Taranis-Project/Taranis_minifusee/README.md

# Taranis_minifusee
Files used for our first minifusee
