Taranis-Project/Taranis_minifusee/Electronique/Composants mini-fusée.docx

Carte arduino grande :

Référence : arduino

Epaisseur max : 15 mm masse : 23,0 g

53,5 mm

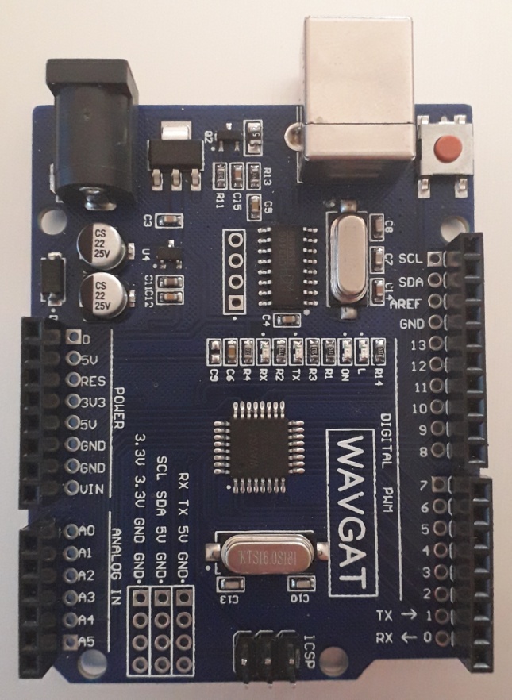
[picture p1: figure]

= 74,5 mm

6 mm

68,5 mm

Carte arduino petite :

Référence : pro mini

Epaisseur max : 13,5 mm masse : 2,6 g

18 mm

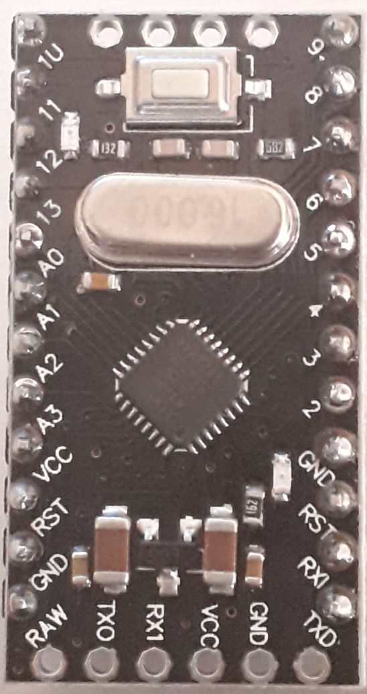
[picture p2: figure]

33,5 mm

Accéléromètre-Gyroscope :

Référence : MPU 6050

Epaisseur max : 11,5 mm masse : 1,6 g

16,5 mm

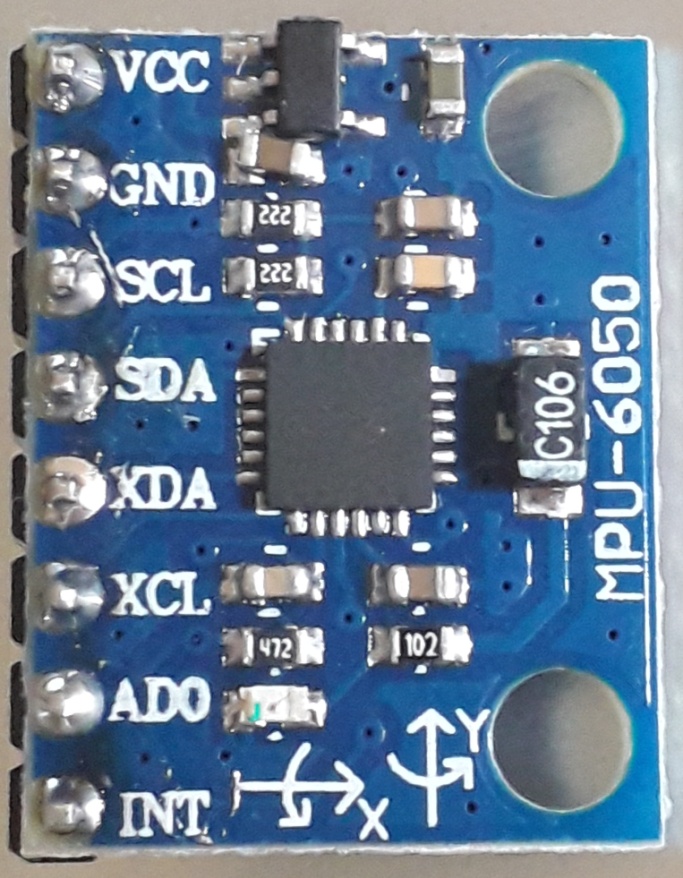
[picture p3: figure]

20,5 mm

Altimètre :

Référence : CJMCU-280E BME 280

Epaisseur max : 11,5 mm

12,0 mm

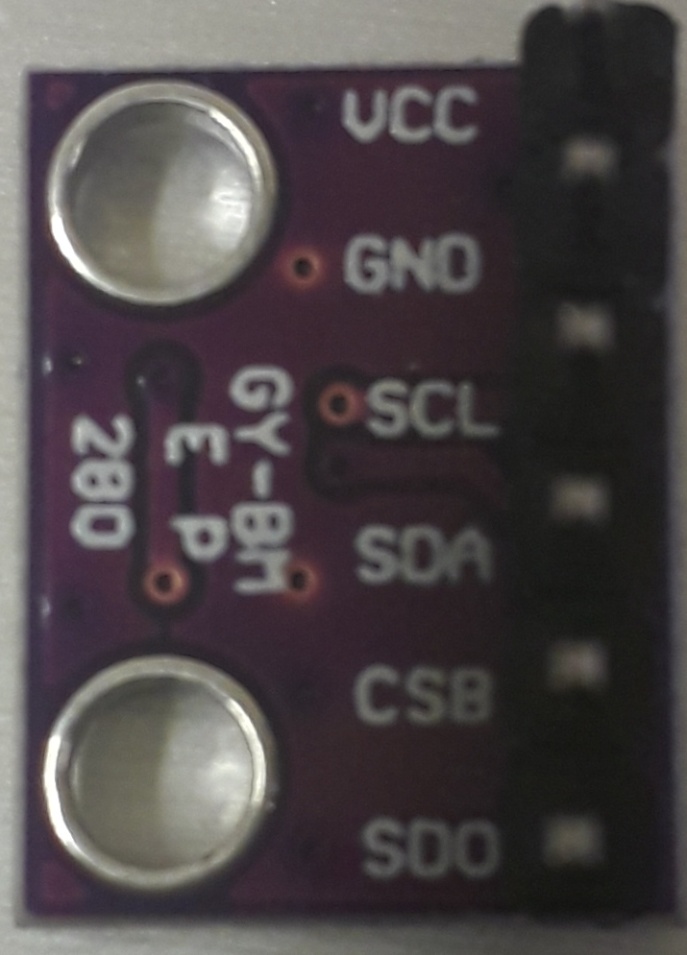
[picture p4: figure]

15,5 mm

Module SD

Référence : micro SD card module

Epaisseur max : 11,5 mm masse : 1,9 g

21,0 mm

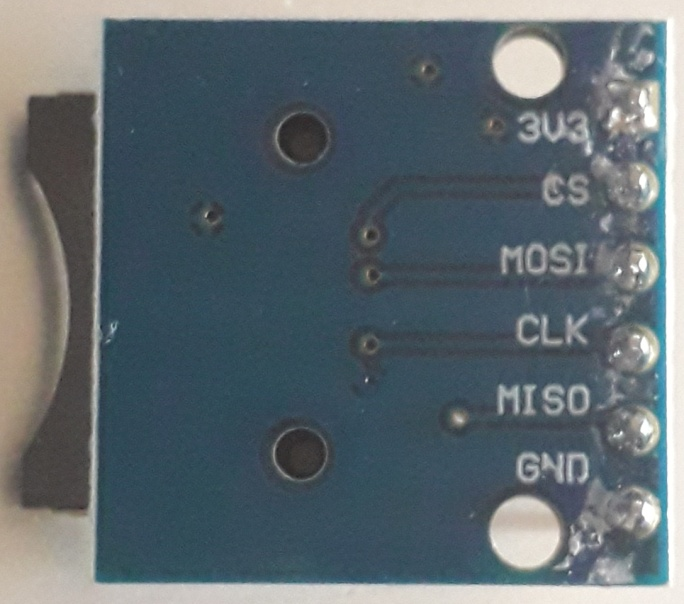
[picture p5: figure]

18,5 mm
