Taranis-Project/Taranis_minifusee/Intégration/Contrainte intégration.docx

- Partie électronique imperméable
- Interrupteurs et LED à l’extérieur
- Communiquer avec les cartes sur la rampe
- Possibilité de démontage et remplacement des piles
- Centre de masse au milieu
- Connexion et déconnexion servomoteur ???
