Taranis-Project/Taranis_minifusee/Rédaction/Suivi des séances.docx

Séance du 05/02/2020

Objectif : répartir les tâches de travail au sein du groupe

Chef de projet : Alexandre Leleux

Responsable électronique : Léo-Paul Laurent

Responsable CAO : Florian Levray

Responsable Intégration : Marie Brun

Suivi des projets : Corentin Copet

Numéro de tel Planète Science pour nous aider tous les mercredis de 19H à 00H : 01 69 02 76 10

Travail effectué :

Rouge : Vcc Noir : Ground Blanc : Rx Vert : Tx

Processeur 3.3V USB ASP

Alexandre a noté les dimensions de tous les composants électroniques utilisés.

Florian a réparé le câble de connexion mini et a réussi à communiquer une mini avec C++.

Corentin a réalisé le schéma électronique sur Fritzing.

Melvin a programmé le déclenchement du parachute, est parti plus tôt pour programmé à 17H04.

Léo-Paul a regardé les programmes pour voir comment modifier les PIN de connexion.

Marie a vérifié les cartes, a soudé, a lu le dossier d’intégration.

A reprendre :

Problème de connexion entre l’altimètre et le gyroscope car connecté sur un même pin SDA et SCL.

Voir connexion I2C
