Taranis-Project/Taranis_minifusee/Chronologie.ods

Sheet: Chronologie
Décompte | Durée | Lieu | Opération | Séquence | Validée | Responsable |  |  |  | Version simplifié
 |  |  |  |  |  | Florian | Marie | Léo-Paul
 |  |  | Veille
-14h20 ou plus | 2h00 | Ville | Rechargement piles 9V | I |  | X |  |  | Piles | Caméra 1 | Lancer | Mettre coiffe avant/aprés?
-12h20 | 5h00 | Chambre | Rechargement ordinateurs | I |  | X | X |  | Ordinateur + cable de rechargement | Caméra 2 | Lancer
-12h15 | 5h00 | Chambre | Rechargement des caméras | I |  | X | X |  | cable de rechargement caméra | Branche jack
-12h10 | 10 min | Chambre | Test logiciel d'enregistrement/connexion internet | I |  | X |  | X |  | Test anti ouverture
-12h05 | 5 min | Chambre | Test logiciel d'enregistrement Sérial | I |  | X |  | X |  | Télém | Bas
 |  |  | Pres déplacement |  |  |  |  |  |  | Exp | Bas
-01:52 | 5 min | Ordinateur | Vérification du matériel | II |  | X | X |  | Ordinateurs/piles/télémesure/pinces/trounevis/ 3 cartes SD/Jack/Fusée/go pro + mini cam + scotch | Séq | Bas
-01:47 | 5 min | Ordinateur | Lancement du stream et de l'enregistrement | II |  | X | X |  |  | Servo oreille
-01:42 | 0 min | Caméra ordi | Jean michel cadrage | II |  |  |  | X |  | Vérif télém
-01:42 | 3 min | Fusée | Mise en place des piles | II |  | X |  |  | Piles | Vérif données corectes
-01:39 | 1 min | Fusée | Mise en place des cartes SD vierges données/ vierge caméra 1 & 2 | II |  | X |  |  | cartes SD
 |  |  | Test prés montage |  |  |  |  |  | pince
-01:38 | 3 min | Fusée | Test allumage séquenceur/données/caméra1 & 2 | III |  | X
-01:35 | 1 min | Ordinateur | Vérification télémétrie | III |  |  |  | X
-01:34 | 5 min | Ordinateur | Vérification des cartes SD | III |  | X
-01:29 | 3 min | Ordinateur | Effacer cartes SD | III |  | X
-01:26 | 2 min | Fusée | Mise en place carte SD | III |  | X
-01:24 | 3 min | Fusée | Mise en place éléctronique et vissage. | III |  | X | X
-01:21 | 1 min | Fusée | Test allumage séquenceur/exp | III |  | X |  | X
-01:20 | 1 min | Fusée | Vérification télémétrie | III |  | X |  | X
-01:19 | 3 min | Fusée | Vérfication ouverture parachute | III |  | X | X
-01:16 | 3min | Fusée | Mise en place finale de la trappe | III |  | X |  | X
-01:13 | 6 min | Fusée | Test caméra 1 & 2 | III |  | X
-01:07 | 3 min | Fusée | Mise en place caméra 1 & 2 (serrage fort) | III |  | X | X
-01:04 | 5 min | Fusée | Serrage de toutes les vis | III |  | X | X
-00:59 | 5 min | Fusée | Préparation déplacement fusée | III |  | X | X
-00:54 | 5 min | Matériel | Chargement de la fusée + cable jack + pince + télém + ordinateur+tournevis+clé | III |  | X | X |  | Ordinateurs/piles/télémesure/pinces/trounevis/ 3 cartes SD/Jack/Fusée
 |  |  | Déplacement vers la rampe
-00:49 | 15 min | Camion | Protection de la fusée |  |  | X | X |  | Sangle/plaque de transport
 |  |  | Test en tente club
-00:34 | 1 min |  | Branchement prise Jack | IV | X |  | X
-00:33 | 1 min |  | Allumage séquenceur et expérience | IV |  | X
-00:32 | 1 min |  | Vérfication télémétrie | IV | X | x
-00:31 | 1 min |  | Arrêt séquencer et expérience + rangement jack | IV |  | X | X
-00:30 | 1 min | Fusée | Lancement caméra 1 HD (bouton Haut/Bas/Haut) + prendre heure | IV
-00:29 | 1 min | Fusée | Lancement caméra 2 HD (bouton Haut/Bas/Haut) + prendre heure | IV |  | X | X
 |  |  | En rampe | IV |  | X
-00:28 | 1 min | Caméra ext | Mise en place caméra sur rampe | IV |  | X | RESP CHRONO
-00:27 | 1 min | Caméra ext | Mise en place caméra trépied | IV |  | X | RESP CHRONO
-00:26 | 1 min | Fusée | Vérif trappe | IV |  | X | RESP CHRONO
-00:25 | 1 min | Fusée | Mise en rampe de la fusée | IV |  | X | RESP CHRONO
-00:24 | 1 min | Fusée | Allumage expérience 3 | IV |  | X | RESP CHRONO
-00:23 | 1 min | Fusée | demander allumage télém | IV |  | X | RESP CHRONO
-00:22 | 1 min | Fusée | allumage télém 2 | IV |  | X | RESP CHRONO
-00:21 | 1 min | Ordinateur | Vérification réception donnée | IV |  | X | RESP CHRONO
-00:20 | 1 min | Ordinateur | Vérification qualité donnée | IV |  |  | RESP CHRONO | X
-00:19 | 1 min | Ordinateur | lancement de la réception de la télémétrie | IV |  | X | RESP CHRONO
-00:18 | 2 min | Ordinateur | lancement de l'enregistrement de la télémétrie | IV |  | X | RESP CHRONO
-00:16 | 3 min | Pyrotechnicien | Orientation de la rampe | V |  | PS | RESP CHRONO
-00:13 | 3 min | Fusée | Branchement et maintient de la prise Jack | IV |  | X | RESP CHRONO
-00:10 | 1 min | Fusée | Acroche de la prise jack sur le pas de tir | IV |  | X | RESP CHRONO
-00:09 | 1 min | Fusée | Allumage séquenceur 1 | IV |  | X | RESP CHRONO
-00:08 | 30 sec | Fusée | Bruit servomoteur ? | IV |  | X | RESP CHRONO
-00:06 | 1 min | Ordinateur | Vérification donnée Sérial | IV |  | X | RESP CHRONO
-00:05 | 1 min | Fusée | Vérification visuelle LED/Cable Jack | IV |  | X | RESP CHRONO
-00:04 | 2 min | Ordinateur | Evacuation des lieux
 |  |  | Tente pupitre
-00:02 | 1 min | Télémétrie | Antenne perpendiculaire à la fusée | V |  |  | X |  |  |  |  |  | X
-00:01 | 1 min | Vidéos | Caméra / téléphones / ralentis / suivit fusée | V |  | X | X
00:00 | 0 min | Télémétrie | Ultime vérification télémétrie/stream/enregistrement | V |  | X | X | X
 |  | Gros bouton rouge | Lancement de la fusée | V |  | X
 |  |  | ENJOY(Florian Crie probablement)
 |  |  | Post lancement
Inconnue |  |  | Impression | VI |  | X | X
Inconnue |  |  | Sauvegarde des données Télémétrie | VI |  | X |  | X
Inconnue |  |  | Analyse des données | VI |  | X | X
 |  |  | Récupération |  |  |  |  | X
Inconnue |  |  | Prendre des photos avant de déplacer la fusée | VII |  | X | X
Inconnue |  |  | Sauvegarde des données | VII |  | X | X | X
Inconnue |  |  | Sauvegarde des vidéos | VII |  | X | X | X
Inconnue |  |  | Analyse des données | VII |  | X | X | X
Inconnue |  |  | Analyse des vidéos | VII |  | X | X | X

Sheet: Liste_matériel
Pour le lancement | Réparation |  | Vidéo
Fusée | Imprimante 3D |  | Trépied
Support | fil imprimante |  | Pied pour téléphone x2
sangle | glue |  | support téléphones x2
Pince pour caméra | vis rechange |  | OBS
caméra mini | étain
scotch | station soudure
trépied
Go pro | gaine
Ordi 1 | crayon flux
Ordi 2 | tresse à dessouder
cable arduino 1 | Couture
cable arduino 2 | Toile parachute
Télém 1 | bord de couture | Tant pis
Télém 2 | fil de para
Téléphone streaming | papier à poncer
Clé allen | faux moteur
Cable recharge ordi | Servomoteur
Tournevis fusée | scotch
sac/boite pour vis | pistocole
Jack fusée | recharge pistocole
ficelle de secour | élastiques
Caméra melvin live
cable rechargement caméra
Piles 9V neuve x2
recharge pile 9V
Cable téléversement
Composant en double
Arduino mini
MPU
BME
Régulteur
Condo 1
Condo 2
Fils
Connecteur Pile
club golf
