Taranis-Project/Taranis_minifusee/CAO/Taranis Case equipement.stl

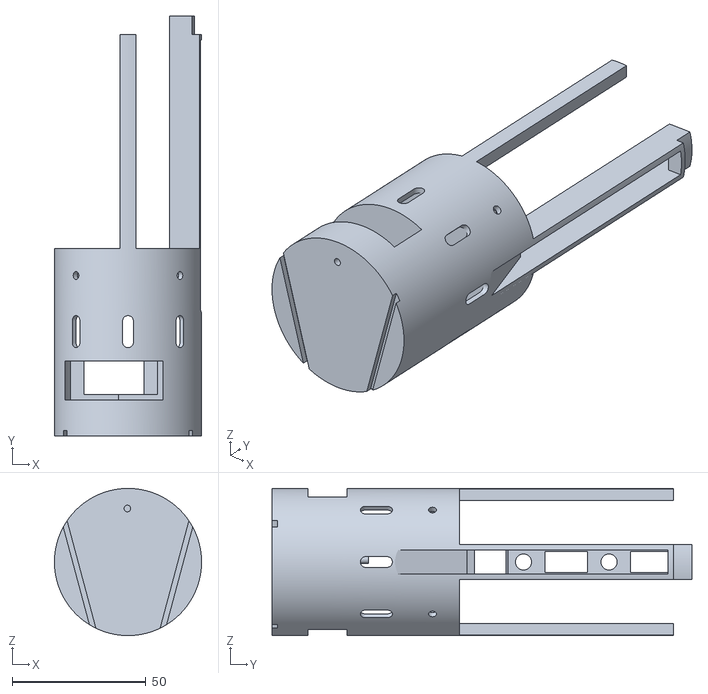
[picture p23: CAD file, 2023-11-09]
CAO/Taranis Case equipement.stl
55.0 x 157.0 x 55.0
