Taranis-Project/Taranis_minifusee/Case a equipement STL.obj

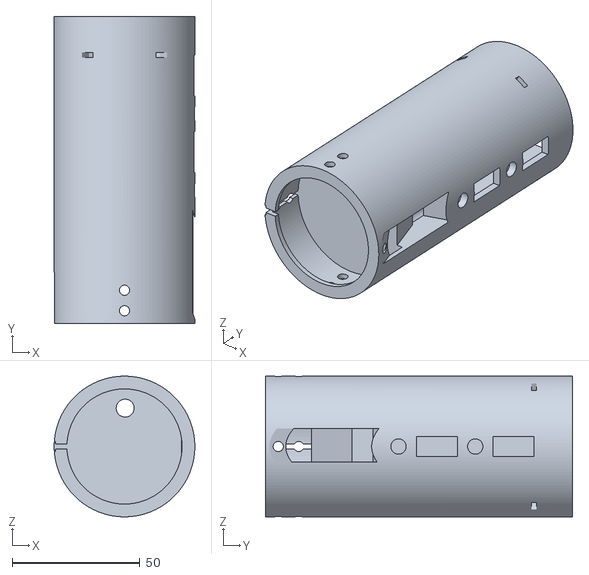
[picture p24: CAD file, 2023-11-09]
Case a equipement STL.obj
55.0 x 120.0 x 55.0
