Taranis-Project/Taranis_minifusee/CAO/Taranis Pochoir bac.stl

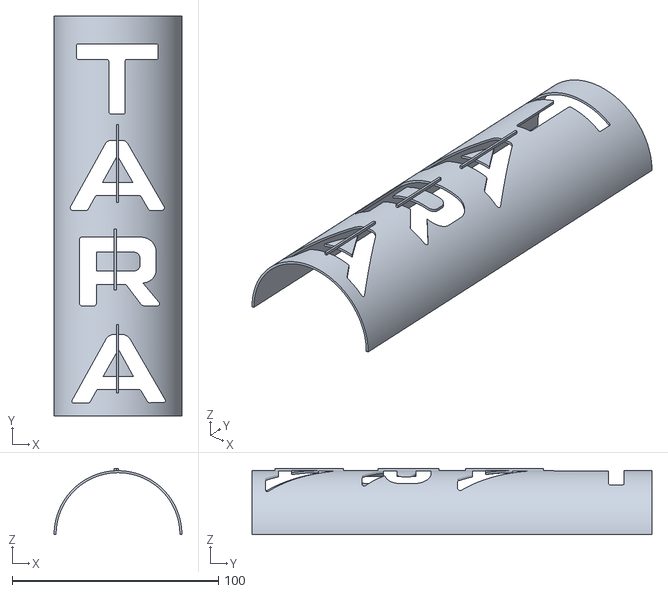
[picture p25: CAD file, 2023-11-09]
CAO/Taranis Pochoir bac.stl
62.0 x 194.0 x 32.1
