Taranis-Project/Taranis_minifusee/CAO/Taranis Base aileron et moteur.stl

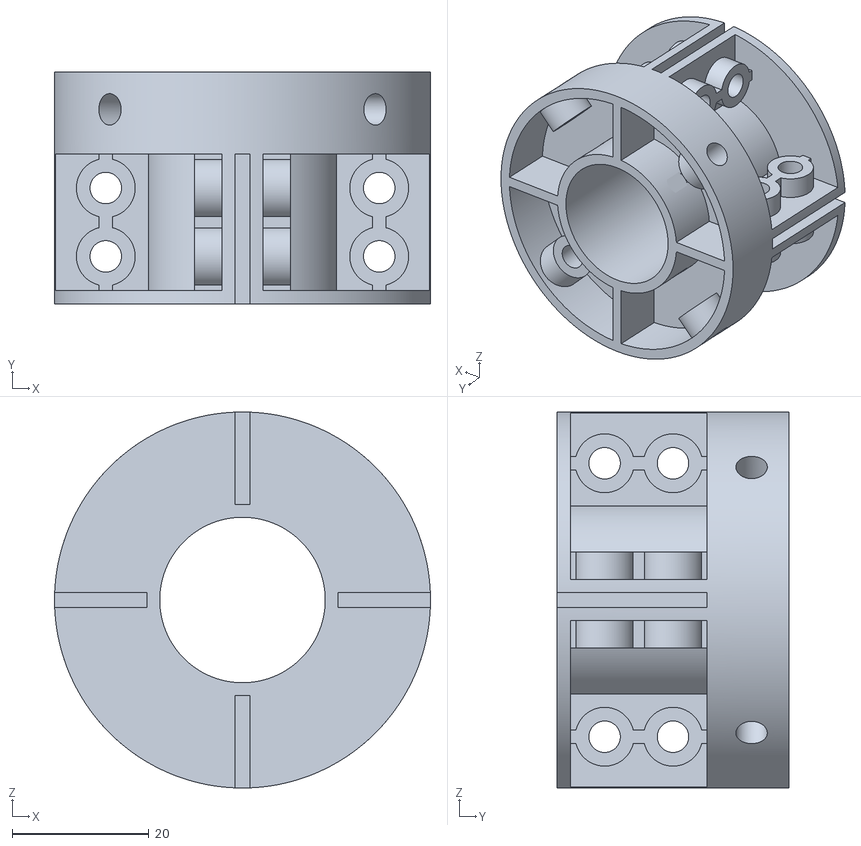
[picture p26: CAD file, 2023-11-09]
CAO/Taranis Base aileron et moteur.stl
55.0 x 34.0 x 55.0
