Taranis-Project/Taranis_minifusee/CAO/TelemHaut.stl

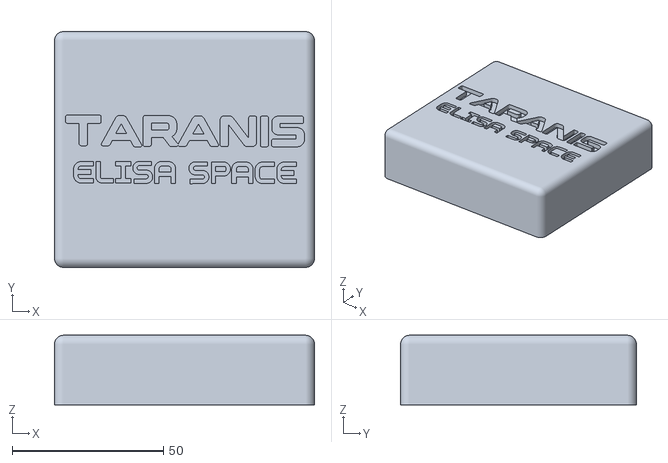
[picture p27: CAD file, 2023-11-09]
CAO/TelemHaut.stl
86.0 x 78.0 x 23.0
