Taranis-Project/Taranis_minifusee/CAO/Moteur Pandora.stl

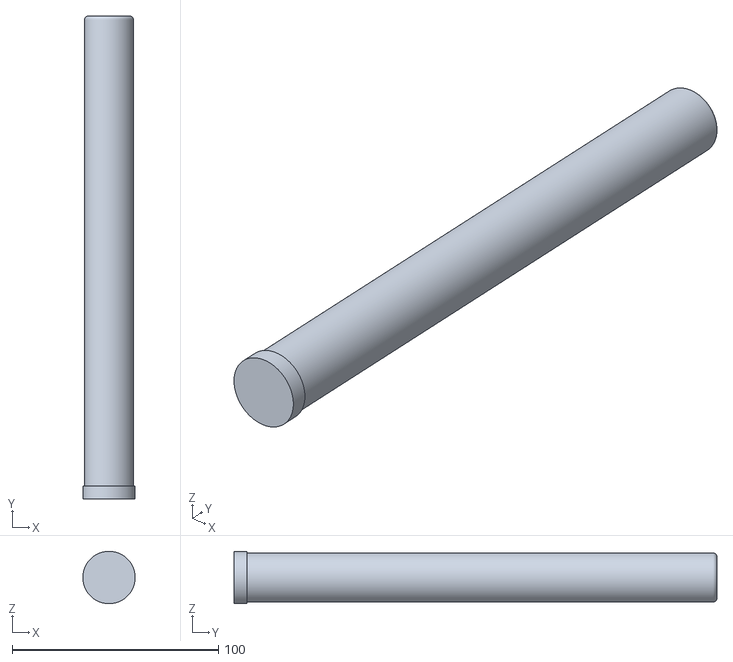
[picture p28: CAD file, 2023-11-09]
CAO/Moteur Pandora.stl
25.4 x 234.4 x 25.4
