Taranis-Project/Taranis_minifusee/CAO/Taranis Camera2.stl

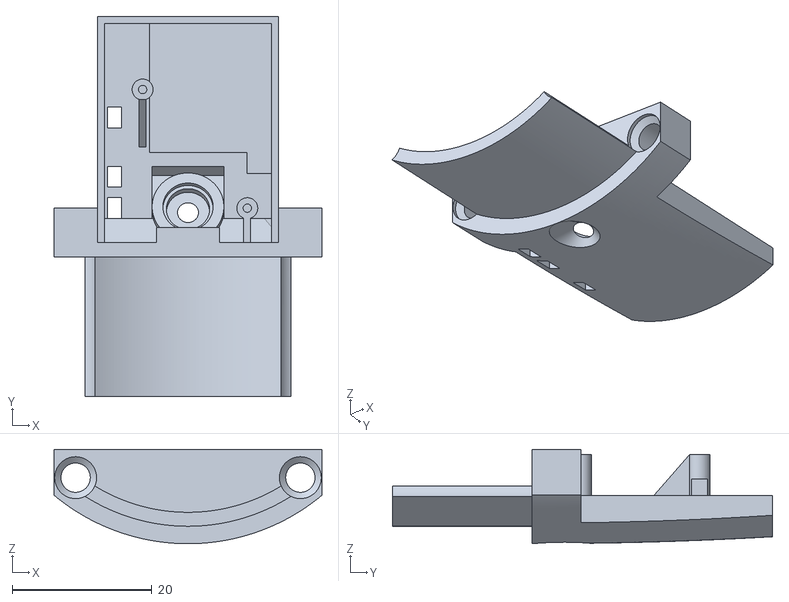
[picture p29: CAD file, 2023-11-09]
CAO/Taranis Camera2.stl
38.4 x 54.5 x 13.5
