Taranis-Project/Taranis_minifusee/CAO/Taranis Pochoir.stl

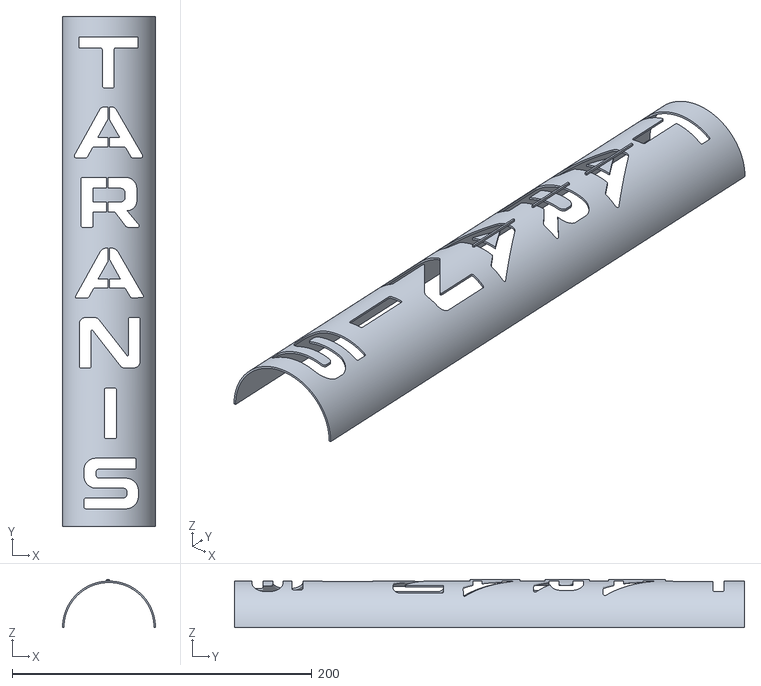
[picture p30: CAD file, 2023-11-09]
CAO/Taranis Pochoir.stl
62.0 x 340.0 x 32.1
