Taranis-Project/Taranis_minifusee/CAO/Taranis Pignon.stl

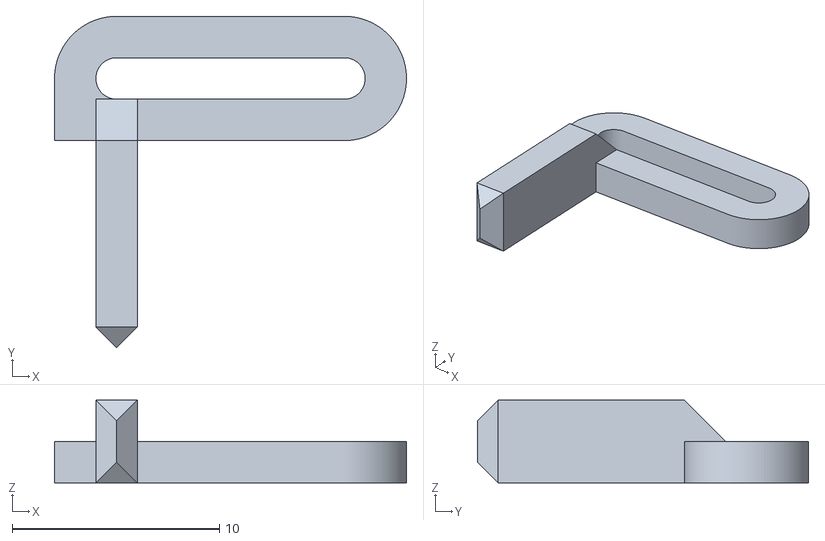
[picture p31: CAD file, 2023-11-09]
CAO/Taranis Pignon.stl
17.0 x 16.0 x 4.00
