Taranis-Project/Taranis_minifusee/CAO/Taranis Support moteur.stl

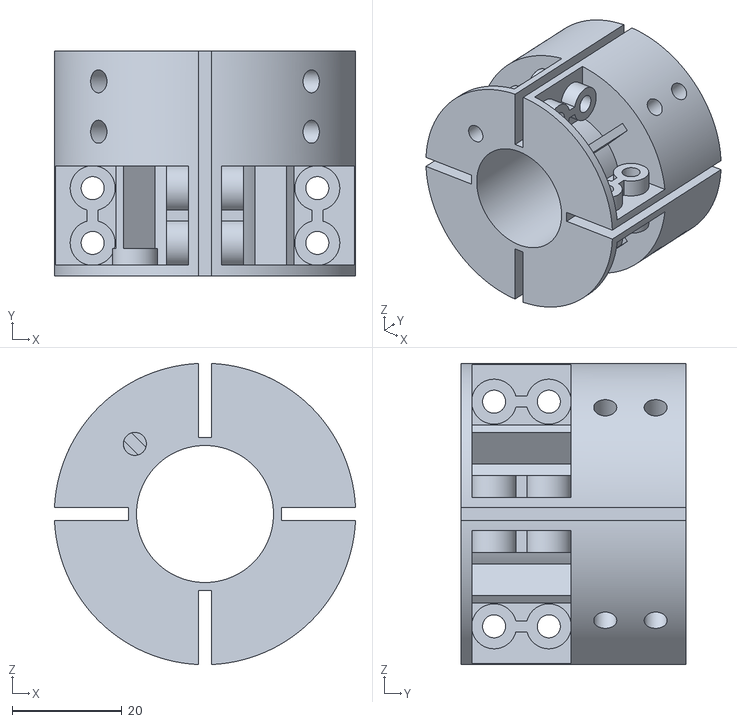
[picture p32: CAD file, 2023-11-09]
CAO/Taranis Support moteur.stl
54.9 x 41.0 x 54.9
