Taranis-Project/Taranis_minifusee/CAO/Taranis Pochoir Elisa Bas.stl

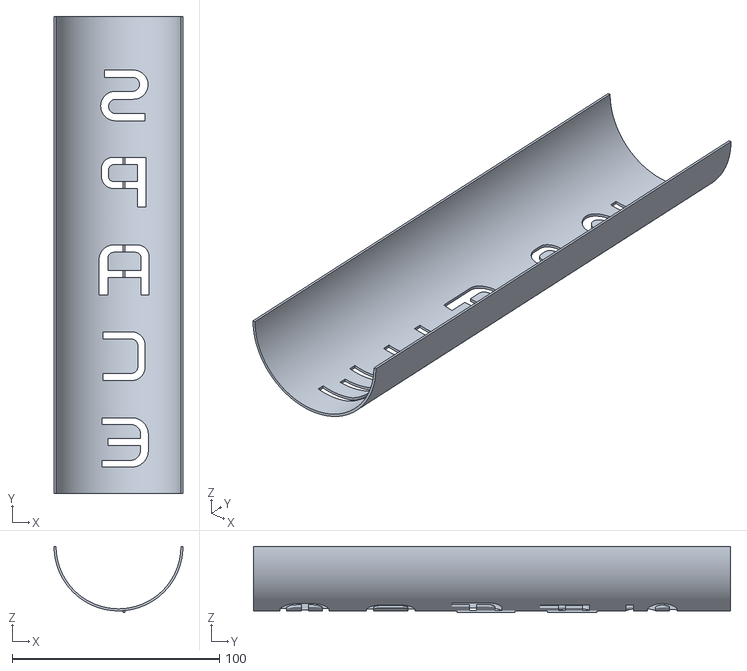
[picture p33: CAD file, 2023-11-09]
CAO/Taranis Pochoir Elisa Bas.stl
62.2 x 230.0 x 31.9
