Taranis-Project/Taranis_minifusee/CAO/TelemText.stl

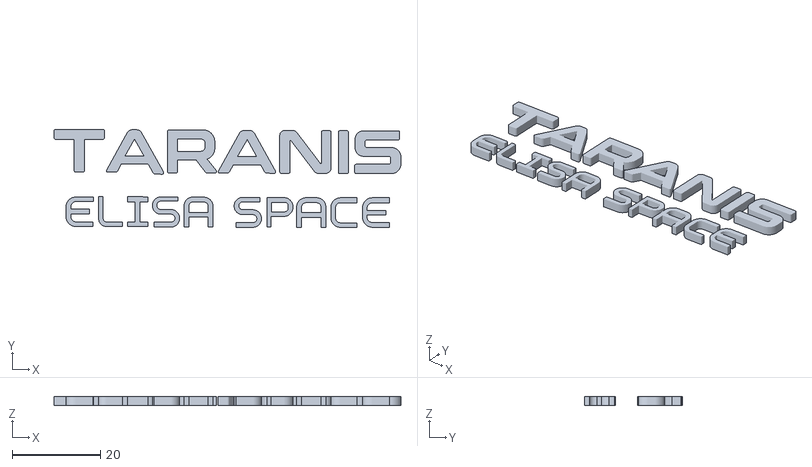
[picture p34: CAD file, 2023-11-09]
CAO/TelemText.stl
78.7 x 22.3 x 2.00
