Taranis-Project/Taranis_minifusee/CAO/Taranis Paroie retention moteur.stl

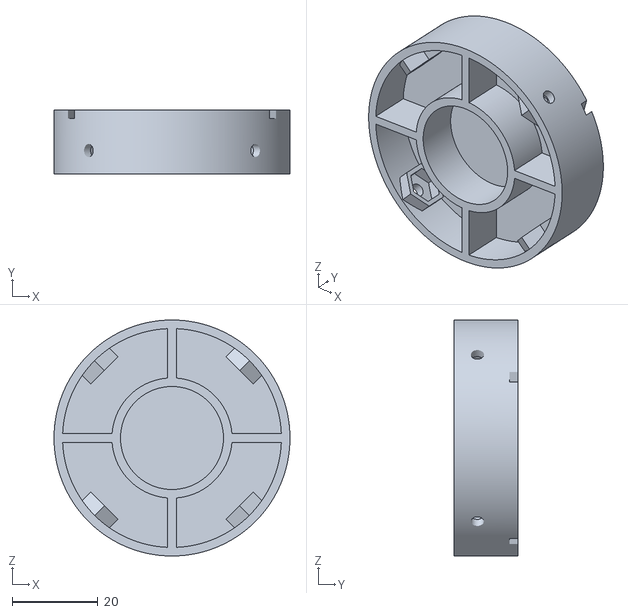
[picture p35: CAD file, 2023-11-09]
CAO/Taranis Paroie retention moteur.stl
55.0 x 15.0 x 55.0
