Taranis-Project/Taranis_minifusee/CAO/Taranis Pied.stl

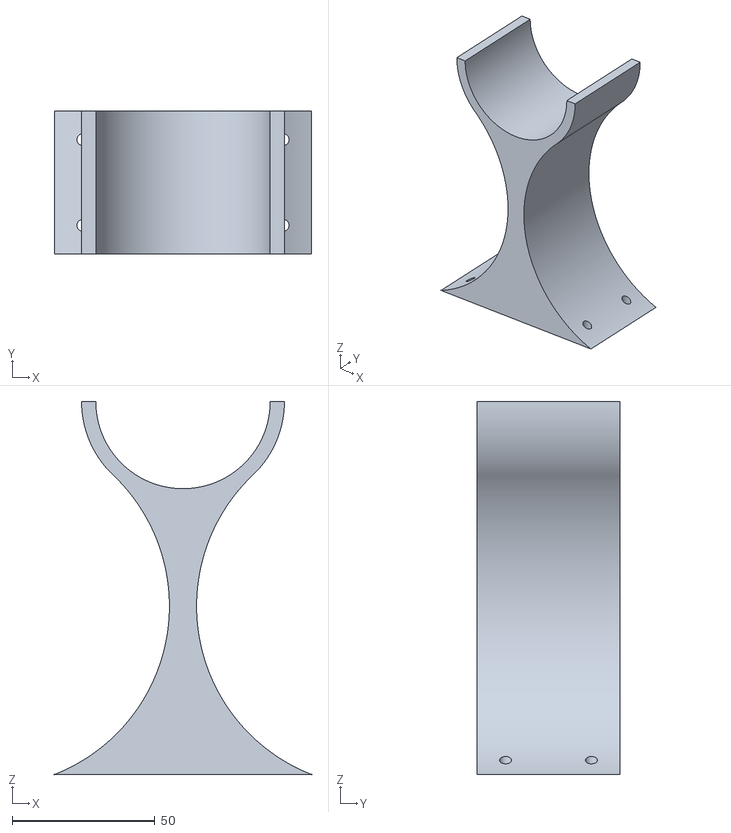
[picture p36: CAD file, 2023-11-09]
CAO/Taranis Pied.stl
90.0 x 50.0 x 130.5
