Taranis-Project/Taranis_minifusee/CAO/BQW2_Taranis Support aileron et moteur.3mf

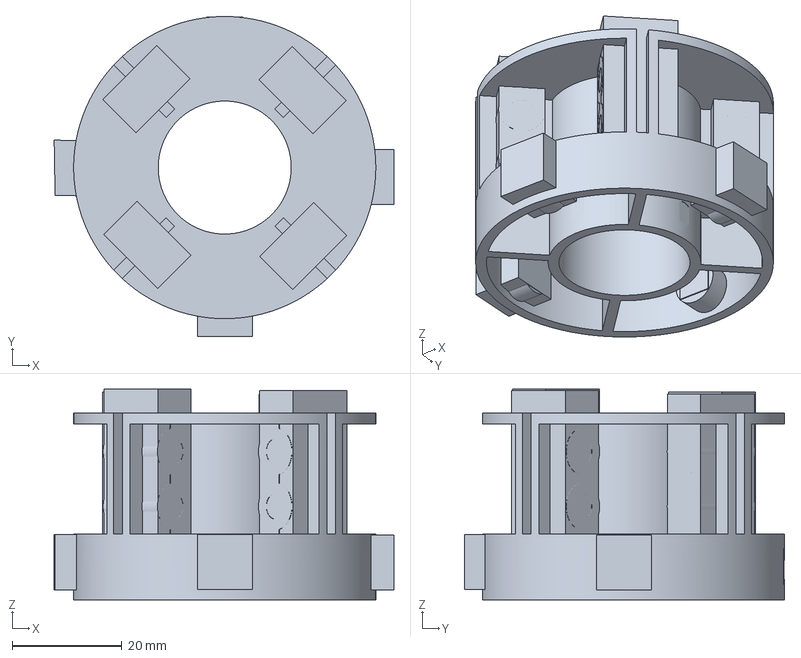
[picture p37: CAD file, 2023-11-09]
CAO/BQW2_Taranis Support aileron et moteur.3mf
61.8 x 58.3 x 38.4 mm
