Taranis-Project/Taranis_minifusee/CAO/Taranis Pochoir Elisa Haut.stl

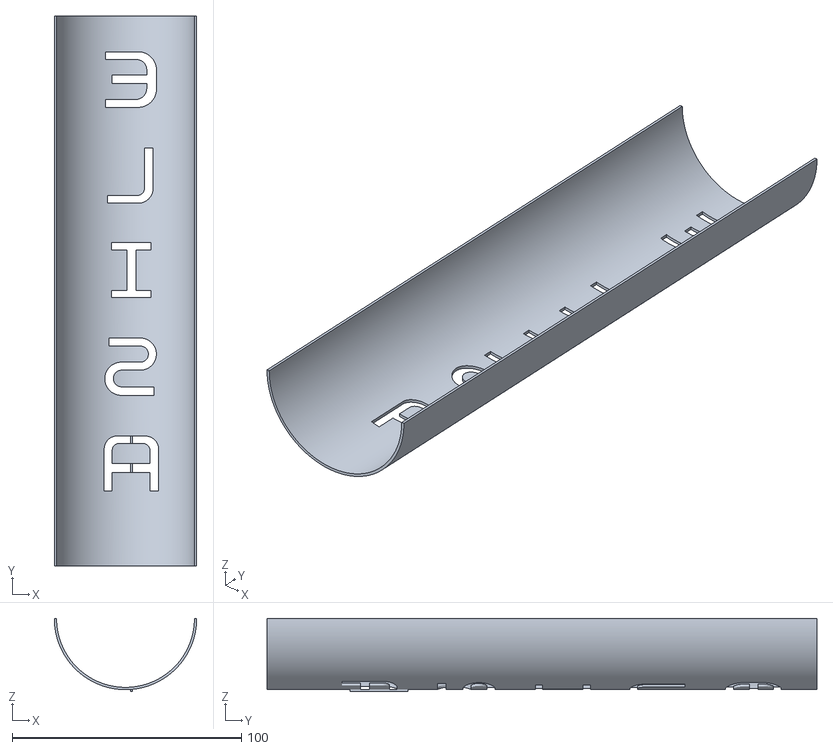
[picture p38: CAD file, 2023-11-09]
CAO/Taranis Pochoir Elisa Haut.stl
62.2 x 240.0 x 31.9
