Taranis-Project/Taranis_minifusee/CAO/Taranis Case parachute et electronique.stl

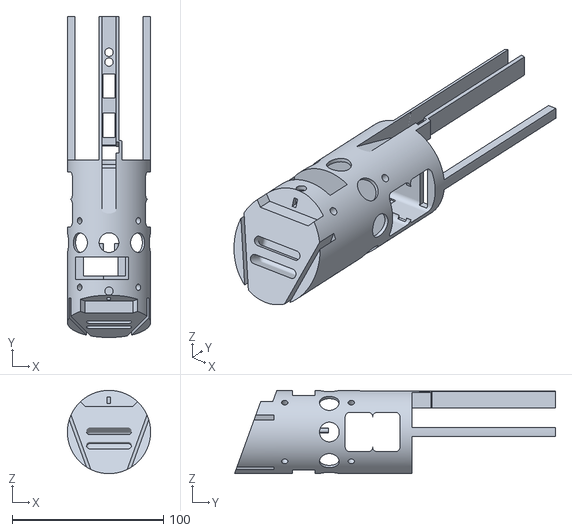
[picture p39: CAD file, 2023-11-09]
CAO/Taranis Case parachute et electronique.stl
55.0 x 212.2 x 55.0
