Taranis-Project/Taranis_minifusee/CAO/BQW2_Taranis Case parachute et electronique.3mf

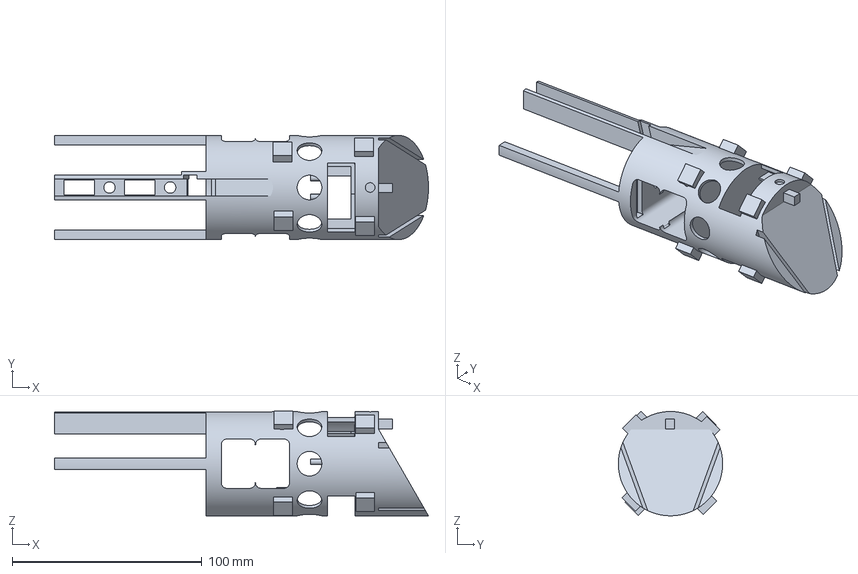
[picture p40: CAD file, 2023-11-09]
CAO/BQW2_Taranis Case parachute et electronique.3mf
197.3 x 55.0 x 55.2 mm
