Taranis-Project/Taranis_minifusee/CAO/Taranis Aide percage.stl

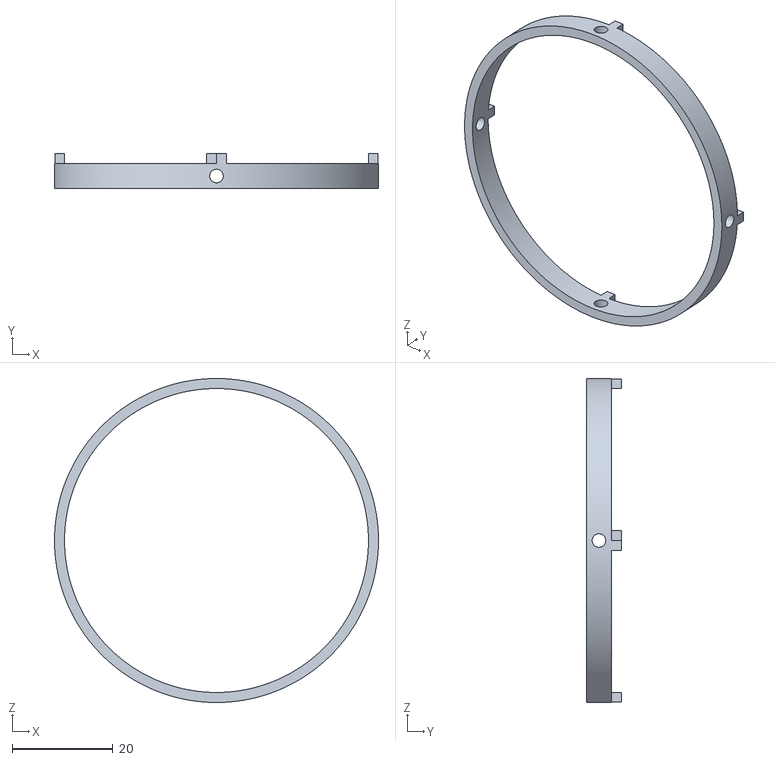
[picture p41: CAD file, 2023-11-09]
CAO/Taranis Aide percage.stl
64.4 x 7.00 x 64.4
