Taranis-Project/Taranis_minifusee/CAO/Taranis Fusee a eau.stl

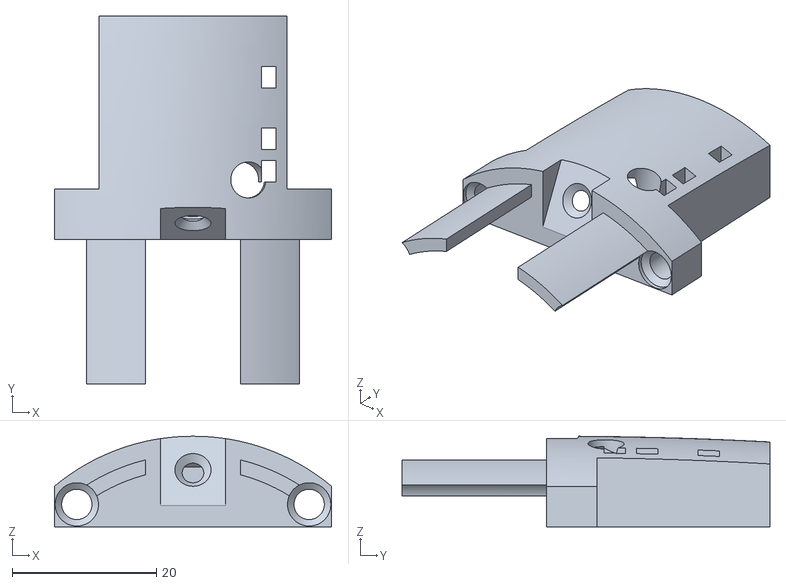
[picture p42: CAD file, 2023-11-09]
CAO/Taranis Fusee a eau.stl
38.4 x 51.0 x 12.5
