Taranis-Project/Taranis_minifusee/CAO/Drawing1.dxf

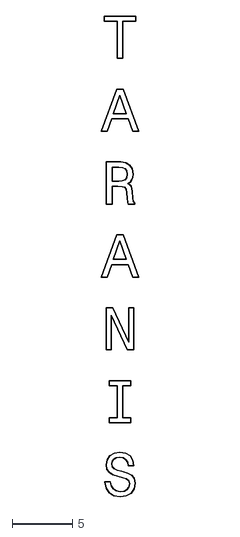
[picture p43: CAD file, 2023-11-09]
CAO/Drawing1.dxf
3.07 x 39.9
