Taranis-Project/Taranis_minifusee/CAO/TelemBas.stl

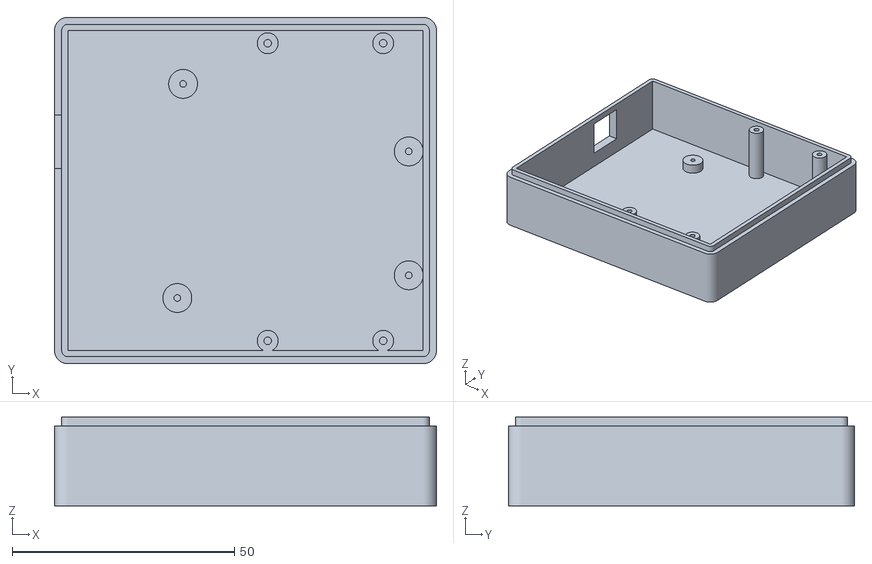
[picture p44: CAD file, 2023-11-09]
CAO/TelemBas.stl
86.0 x 78.0 x 20.0
