Taranis-Project/Taranis_minifusee/CAO/Taranis Support moteur et parachute.stl

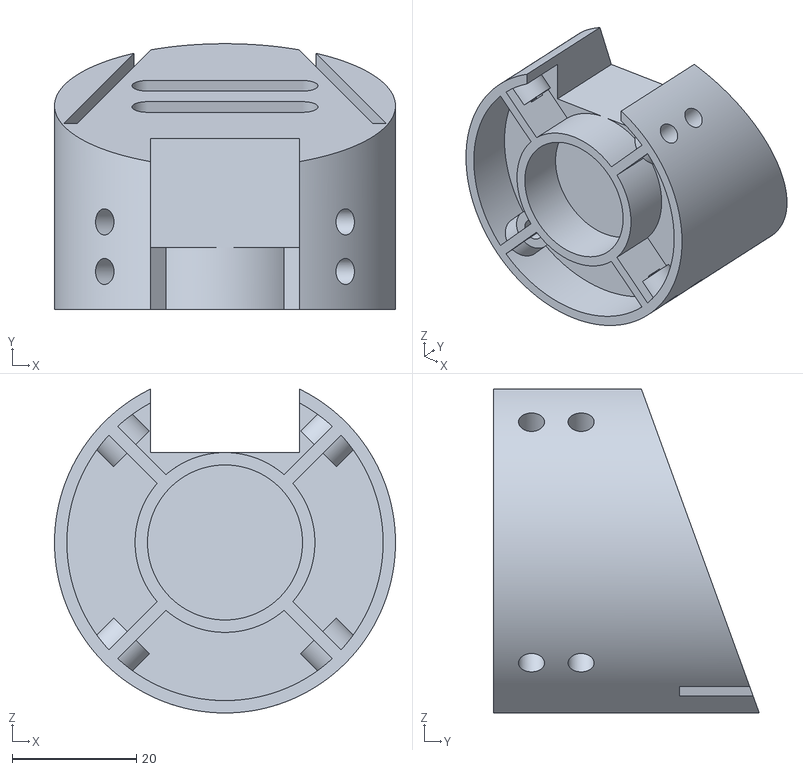
[picture p45: CAD file, 2023-11-09]
CAO/Taranis Support moteur et parachute.stl
55.0 x 42.8 x 52.2
