Taranis-Project/Taranis_minifusee/CAO/Taranis Camera1.stl

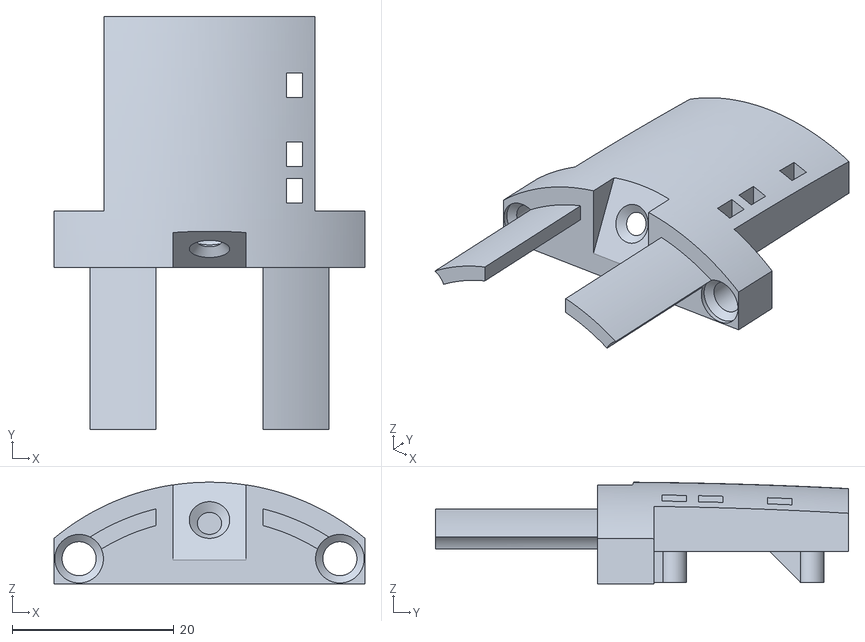
[picture p46: CAD file, 2023-11-09]
CAO/Taranis Camera1.stl
38.4 x 51.0 x 12.5
