Taranis-Project/Taranis_minifusee/CAO/Taranis Trappe.stl

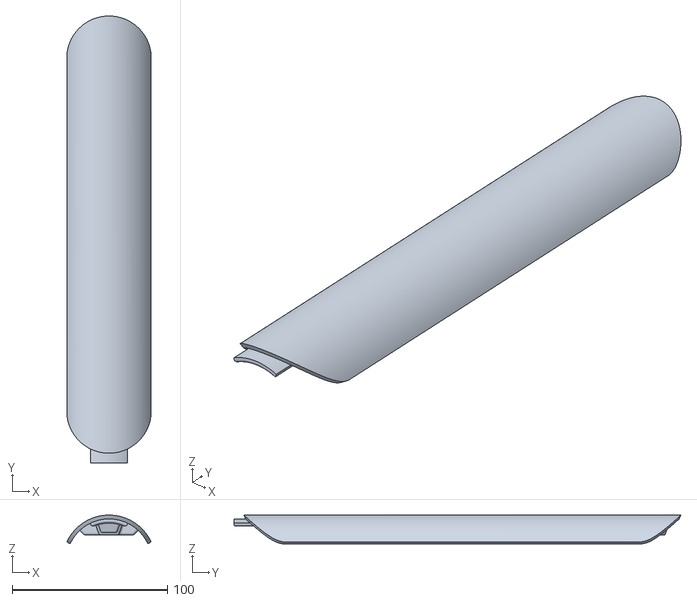
[picture p47: CAD file, 2023-11-09]
CAO/Taranis Trappe.stl
54.3 x 287.7 x 18.5
