Taranis-Project/Taranis_minifusee/(list of files, cad)

Other CAD files:
CAO/Taranis Support aileron et moteur.stl
CAO/Ailerons.CATPart
CAO/Axe Servomoteur.CATPart
CAO/Boitier_Servomoteur.CATPart
CAO/Bras Servomoteur.CATPart
CAO/Case a equipement.CATPart
CAO/Moteur Pandora.CATPart
CAO/Part1 bis.CATPart
CAO/Part1.CATPart
CAO/Part11.CATPart
CAO/Part12.CATPart
CAO/Part13.CATPart
CAO/Part14.CATPart
CAO/Part2.CATPart
CAO/Part3.CATPart
CAO/Part4.CATPart
CAO/Part5.CATPart
CAO/Part6.CATPart
CAO/Part7.CATPart
CAO/Part8.3.CATPart
CAO/Part8.5.CATPart
CAO/Part8.CATPart
CAO/Part9.CATPart
CAO/Piece de maintient coiffe.CATPart
CAO/Servomoteur.CATProduct
CAO/Taranis.CATProduct
CAO/TelemBas.CATPart
CAO/Telemesure Sol.CATProduct
CAO/Tube principal - Copie.CATPart
CAO/Tube principal.CATPart
CAO/Verrou.CATPart
