Taranis-Project/Taranis_minifusee/(list of files, drawings)

Other design files:
Documents-entretien-visio/test.fzz
Electronique/enregistreur de vol.fzz
Electronique/Systéme final.fzz
Electronique/test.fzz
Electronique/Télém/Untitled Sketch.fzz
Electronique/Untitled Sketch 2.fzz
Intégration/PCB/PCB.fzz
