Taranis-Project/Taranis_minifusee/Electronique/Arduino Florian Levray/Write_SD/Write_SD.ino

/*
 * SD card formated FAT
 ** MOSI - pin 11
 ** MISO - pin 12
 ** CLK - pin 13
 ** CS - pin 4 (for MKRZero SD: SDCARD_SS_PIN)
 */

#include <SPI.h>
#include <SD.h>

File myFile;

void setup() {
  // Open serial communications and wait for port to open:
  Serial.begin(9600);
  while (!Serial) {
    ; // wait for serial port to connect. Needed for native USB port only
  }

  Serial.print("Initializing SD card...");

  if (!SD.begin(10)) {
    Serial.println("initialization failed!");
    while (1);
  }
  Serial.println("initialization done.");

  myFile = SD.open("test.txt", FILE_WRITE);
}

void loop() {
  myFile = SD.open("test.txt", FILE_WRITE);
  if(myFile){
    Serial.println(myFile);
  for(int x = 0; x<10; x++){
    myFile.println(x);
  }
  myFile.close();
  }
}
