Taranis-Project/Taranis_minifusee/Electronique/Programmation composants/Arduino_flightRecorder/Arduino_flightRecorder.ino

#include <Wire.h>
#include <SPI.h>
#include <SD.h>

// NOTE : temperature correction temp°C = Tmp/340.00+36.53

// MPU6050 settings and variables
const int MPU_addr=0x68;  // I2C address of the MPU-6050
int16_t AcX,AcY,AcZ,Tmp,GyX,GyY,GyZ;

// SD Reader settings
const int chipSelect = 4;

void setup() {
  // put your setup code here, to run once:
  Serial.begin(1000000);
    while (!Serial) {
      ; // wait for serial port to connect. Needed for native USB port only
    }


  Serial.print("Initializing SD card...");

  // see if the card is present and can be initialized:
  if (!SD.begin(chipSelect)) {
    Serial.println("Card failed, or not present");
    // don't do anything more:
    return;
  }
  Serial.println("card initialized.");

  Wire.begin();
  Wire.beginTransmission(MPU_addr);
  Wire.write(0x6B);  // PWR_MGMT_1 register
  Wire.write(0);     // set to zero (wakes up the MPU-6050)
  Wire.endTransmission(true);
}

void loop() {
  // Get sensor values
  Wire.beginTransmission(MPU_addr);
  Wire.write(0x3B);  // starting with register 0x3B (ACCEL_XOUT_H)
  Wire.endTransmission(false);
  Wire.requestFrom(MPU_addr,14,true);  // request a total of 14 registers
  AcX=Wire.read()<<8|Wire.read();  // 0x3B (ACCEL_XOUT_H) & 0x3C (ACCEL_XOUT_L)    
  AcY=Wire.read()<<8|Wire.read();  // 0x3D (ACCEL_YOUT_H) & 0x3E (ACCEL_YOUT_L)
  AcZ=Wire.read()<<8|Wire.read();  // 0x3F (ACCEL_ZOUT_H) & 0x40 (ACCEL_ZOUT_L)
  Tmp=Wire.read()<<8|Wire.read();  // 0x41 (TEMP_OUT_H) & 0x42 (TEMP_OUT_L)
  GyX=Wire.read()<<8|Wire.read();  // 0x43 (GYRO_XOUT_H) & 0x44 (GYRO_XOUT_L)
  GyY=Wire.read()<<8|Wire.read();  // 0x45 (GYRO_YOUT_H) & 0x46 (GYRO_YOUT_L)
  GyZ=Wire.read()<<8|Wire.read();  // 0x47 (GYRO_ZOUT_H) & 0x48 (GYRO_ZOUT_L)

  // Generate the string and print it on the SD card
  String dataString = ":" + String(micros()) + "microsec," + String(AcX) + "x," + String(AcY) + "y," + String(AcZ) + "z," + String(GyX) + "roll," + String(GyY) + "pitch," + String(GyZ) + "roll," + String(Tmp);
  File dataFile = SD.open("datalog.txt", FILE_WRITE);
  if (dataFile) {
    dataFile.println(dataString);
    Serial.println(dataString);
  }
  else {
    Serial.println("Error writing to file");
  }
  dataFile.close();
}
