Taranis-Project/Taranis_minifusee/(notices)

Notices in the files:
Case a equipement STL.obj:
Copyright 2004-2020 Aspose Pty Ltd.
